cfpwastaken/epaperframe/(list of files, drawings)

Other design files:
Circuit.fzz
