cfpwastaken/epaperframe/picoCode/epd.py

from framebuf import FrameBuffer, GS4_HMSB
from machine import Pin, SPI
from utime import sleep

led = Pin("LED")

EPD_WIDTH       = 600
EPD_HEIGHT      = 448

RST_PIN         = 12
DC_PIN          = 8
CS_PIN          = 9
BUSY_PIN        = 13

class EPD(FrameBuffer):
    def __init__(self):
        self.reset_pin = Pin(RST_PIN, Pin.OUT)
        
        self.busy_pin = Pin(BUSY_PIN, Pin.IN, Pin.PULL_UP)
        self.cs_pin = Pin(CS_PIN, Pin.OUT)
        self.width = EPD_WIDTH
        self.height = EPD_HEIGHT
        
        self.Black = 0x00
        self.White = 0x01
        self.Green = 0x02
        self.Blue = 0x03
        self.Red = 0x04
        self.Yellow = 0x05
        self.Orange = 0x06
        self.Clean = 0x07
        
        
        self.spi = SPI(1)
        self.spi.init(baudrate=4000_000)
        self.dc_pin = Pin(DC_PIN, Pin.OUT)
        

        self.buffer = bytearray(self.height * self.width // 2)
        super().__init__(self.buffer, self.width, self.height, GS4_HMSB)
        
        self.epdInit()

    def digital_write(self, pin, value):
        pin.value(value)

    def digital_read(self, pin):
        return pin.value()

    def delay_ms(self, delaytime):
        sleep(delaytime / 1000.0)

    def spi_writebyte(self, data):
        self.spi.write(bytearray(data))

    def module_exit(self):
        self.digital_write(self.reset_pin, 0)

    # Hardware reset
    def reset(self):
        self.digital_write(self.reset_pin, 1)
        self.delay_ms(200) 
        self.digital_write(self.reset_pin, 0)
        self.delay_ms(1)
        self.digital_write(self.reset_pin, 1)
        self.delay_ms(200)   

    def send_command(self, command):
        self.digital_write(self.dc_pin, 0)
        self.digital_write(self.cs_pin, 0)
        self.spi_writebyte([command])
        self.digital_write(self.cs_pin, 1)

    def send_data(self, data):
        self.digital_write(self.dc_pin, 1)
        self.digital_write(self.cs_pin, 0)
        self.spi_writebyte([data])
        self.digital_write(self.cs_pin, 1)
        
    def send_data1(self, buf):
        self.digital_write(self.dc_pin, 1)
        self.digital_write(self.cs_pin, 0)
        self.spi.write(bytearray(buf))
        self.digital_write(self.cs_pin, 1)
        
    def BusyHigh(self):
        led.on()
        while(self.digital_read(self.busy_pin) == 0):
            self.delay_ms(1)
        led.off()
            
    def BusyLow(self):
        led.on()
        while(self.digital_read(self.busy_pin) == 1):
            self.delay_ms(1)
        led.off()
        
    def epdInit(self):
        print("Init")
        self.reset();
        self.BusyHigh();
        print("Did high")
        self.send_command(0x00);
        self.send_data(0xEF);
        self.send_data(0x08);
        self.send_command(0x01);
        self.send_data(0x37);
        self.send_data(0x00);
        self.send_data(0x23);
        self.send_data(0x23);
        self.send_command(0x03);
        self.send_data(0x00);
        self.send_command(0x06);
        self.send_data(0xC7);
        self.send_data(0xC7);
        self.send_data(0x1D);
        self.send_command(0x30);
        self.send_data(0x3C);
        self.send_command(0x41); # was 0x40
        self.send_data(0x00);
        self.send_command(0x50);
        self.send_data(0x37);
        self.send_command(0x60);
        self.send_data(0x22);
        self.send_command(0x61);
        self.send_data(0x02);
        self.send_data(0x58);
        self.send_data(0x01);
        self.send_data(0xC0);
        self.send_command(0xE3);
        self.send_data(0xAA);
        
        self.delay_ms(100);
        self.send_command(0x50);
        self.send_data(0x37);

    def epdClear(self,color):
    
        self.send_command(0x61)   # Set Resolution setting
        self.send_data(0x02)
        self.send_data(0x58)
        self.send_data(0x01)
        self.send_data(0xC0)
        self.send_command(0x10)
        for i in range(0,int(self.width / 2)):
            self.send_data1([(color<<4)|color] * self.height)

        self.send_command(0x04)   # 0x04
        self.BusyHigh()
        self.send_command(0x12)   # 0x12
        self.BusyHigh()
        self.send_command(0x02)   # 0x02
        self.BusyLow()
        self.delay_ms(500)
        
    def epdDisplay(self,image):

        self.send_command(0x61)   # Set Resolution setting
        self.send_data(0x02)
        self.send_data(0x58)
        self.send_data(0x01)
        self.send_data(0xC0)
        self.send_command(0x10)
        
        for i in range(0, int(self.width // 2)):
            self.send_data1(image[(i*self.height):((i+1)*self.height)])
#             print(image[(i*self.height):((i+1)*self.height)])
        #print(image[0], image[1], image[2], image[3], image[4], image[5], image[6], image[7], image[8], image[9])
        print("Done!")
        self.send_command(0x04)   # 0x04
        print("Waiting for high")
        self.BusyHigh()
        self.send_command(0x12)   # 0x12
        print("Waiting for high")
        self.BusyHigh()
        self.send_command(0x02)   # 0x02
        print("Waiting for low")
        self.BusyLow()
        self.delay_ms(200)
        print("Should be displaying pic now")
    
    def epdDisplay_part(self,image,xstart,ystart,image_width,image_heigh):

        self.send_command(0x61)   # Set Resolution setting
        self.send_data(0x02)
        self.send_data(0x58)
        self.send_data(0x01)
        self.send_data(0xC0)
        self.send_command(0x10)
        for i in range(0, self.height):
            for j in range(0, int(self.width / 2)):
                if((i<(image_heigh+ystart)) & (i>(ystart-1) ) & (j<(image_width+xstart)/2) & (j>(xstart/2 - 1))):
                    self.send_data(image[(j-xstart/2) + (image_width/2*(i-ystart))])
                else:
                    self.send_data(0x11)

        self.send_command(0x04)   # 0x04
        self.BusyHigh()
        self.send_command(0x12)   # 0x12
        self.BusyHigh()
        self.send_command(0x02)   # 0x02
        self.BusyLow()
        self.delay_ms(200)
                
    def Sleep(self):
        self.delay_ms(100);
        self.send_command(0x07);
        self.send_data(0xA5);
        self.delay_ms(100);
        self.digital_write(self.reset_pin, 1)
