cfpwastaken/epaperframe/(commit log)

2023-12-16 🎉 Initial Commit
    [Circuit.fzz]
2023-12-16 ✨ Work times and web interface
2023-12-24 ✨ Improvements
2023-12-24 🚑️ Allow "always" work times
2024-01-30 🥅 Improve Error handling
    [main.py, server.js]
2024-07-02 ✨ Memory lane and fix for new Immich version
    [server.js]
